murattaguss/cdtp-hasta-destek-robotu/docs/proje-yonetim-plani/100_2627G_CDTP_Yonetim_Plani_Form.docx

YTÜ YTÜ Yıldız Teknik Üniversitesi logosu

ELEKTRİK-ELEKTRONİK FAKÜLTESİ

ÇOK DİSİPLİNLİ TASARIM PROJESİ YÖNETİM PLANI

Not: Formun Arial 10 yazı tipinde doldurulması ve toplam 10 sayfayı geçmemesi gerekmektedir.

Proje Başlığı: İki Tekerlekli Ev İçi Hasta Destek Robotu

Proje Yönetim Planı Teslim Tarihi: 13.11.2026
No | Proje Ekibi Ad, Soyad | Bölüm (ELM/EHM/BLM/KOM/BME) | İmza
1 | Murat AĞUŞ | BLM
2 | Muhammed İSMAİL | BLM
3 | Ahmad KAZIMOV | EHM
4 | Doğa KILIÇ | ELM
5 | Kaan AKBIYIK | KOM
6 | Uğur Can GENÇ | KOM
Danışman: Dr. Öğr. Üyesi Bahadır ÇATALBAŞ

ÖZET

Özetin projenin yöntemi ve yönetimini ana hatlarını kapsaması beklenir. Özet 450 kelime veya bir sayfa ile sınırlandırılmalıdır. Projede yapılan tasarımda gerçekçi kısıtlar ve koşullar gözetilmelidir. Tasarımın niteliğine göre, ekonomi, çevre sorunları, sürdürülebilirlik, üretilebilirlik, etik, sağlık, güvenlik, sosyal ve politik sorunlar gibi öğeler de irdelenmelidir.

Proje Özeti

Bu projede, evde bakım gören yaşlıların veya hareket kabiliyeti kısıtlı hastaların günlük ilaç kutularının ev içinde güvenli, sarsıntısız ve devrilmeden ulaştırılmasını sağlayan iki tekerlekli aktif denge robotu, giyilebilir eldiven kumandası, otonom kızılötesi (IR) şarj istasyonu ve kamera tabanlı mobil görsel değerlendirme yazılımı tasarlanmakta ve gerçekleştirilmektedir. Sistem; Bilgisayar, Kontrol ve Otomasyon, Elektrik ile Elektronik ve Haberleşme mühendisliği disiplinlerinin ortak çalışmasıyla beş ana modülden oluşacak şekilde kurgulanmıştır.

Robot gövdesi üzerinde çift çekirdekli ESP32 (30-Pin) ana kontrolcü, MPU6050 6 eksenli ataletsel ölçüm birimi (IMU), iki adet JGB37-520 (12V, 333 RPM, 1:30 metal redüksiyonlu) kuadratür enkoderli DC motor ve iki adet BTS7960B (40A) motor sürücü kullanılmaktadır. Mekanik yapıda yalnızca gövde plakalarından oluşan iki katmanlı bir şasi kullanılacak; ekstra tekerlek ve kaplin alternatifleri 8. haftada temin edilip fiziksel kurulumla denenecektir. Gövde eğim açısı tamamlayıcı filtre (%98 jiroskop + %2 ivmeölçer) ile 200 Hz (5 ms) frekansında kestirilmekte ve eğim açısı, eğim hızı, tekerlek konumu ve tekerlek hızından oluşan durum vektörünü kullanan ayrık zamanlı LQR (Doğrusal Karesel Düzenleyici) denetleyici ile pasif destek olmadan iki eş eksenli tekerlek üzerinde aktif denge sağlanmaktadır. Kullanıcı, üzerinde NodeMCU ESP8266 ve MPU6050 bulunan bataryalı giyilebilir eldiven ile elini eğerek beş temel komutu (İleri, Geri, Sol, Sağ, Dur) ESP-NOW protokolü üzerinden düşük gecikmeyle (hedef < 50 ms) robota kablosuz iletmektedir. Görev sonunda robot, şarj istasyonunun 30 cm yarıçaplı ve 90° açılı yaklaşma bölgesine girdiğinde istasyondaki 38 kHz LTE-4208 IR verici fenerini gövde üzerindeki üç adet TSOP4038 IR alıcı ile algılayarak otonom hizalanmakta, VL53L0X mesafe sensörüyle yaklaşma hızını ayarlamakta ve robotu dik tutan dayanma yuvasındaki yaylı temas pedlerine kenetlenerek ≤ 5 s içinde insan müdahalesi olmadan şarjı ve donanımsal LED göstergeyi başlatmaktadır.

Bilgisayar Mühendisliği ekibi tarafından Flutter ile geliştirilen çapraz platform (Android ve iOS) mobil uygulama; robotun oluşturduğu yerel Wi-Fi ağı (UDP Port 4210) üzerinden 2 Hz sıklıkla gerçek zamanlı eğim açısı, batarya yüzdesi, şarj ve kenetlenme durumu, enkoder mesafesi, dönüş açısı, eldiven komutu ve ilaç kutusu varlık anahtarı (DC171) verilerini almakta, telefon kamerası ile görev sürecini canlı izleyip kare farkı yöntemiyle robotun hareketini ve yönünü tespit ederek seçilen test senaryosunun (Statik Denge, Eldivenle Yönlendirme, Otomatik Şarj, Bütünleşik Görev) kabul kriterlerini otomatik denetlemekte ve FNV-1a tabanlı 256 bit bütünlük mühürlü, sonradan değiştirilemez (salt-okunur) test raporu üretmektedir. Tasarımda 3S Li-Ion paket için BMS, 6A sigorta, ters akım diyotu ve fiziksel acil durdurma anahtarı kullanılarak güvenlik ve bütçe kısıtları gözetilmiştir.

Anahtar Kelimeler: İki Tekerlekli Aktif Denge Robotu, LQR Durum Geri Beslemeli Kontrol, Giyilebilir IMU Eldiven, ESP-NOW, Otonom Kızılötesi Şarj İstasyonu, Mobil Görsel Görev Değerlendirme, UDP Telemetri, Flutter.

1. GİRİŞ

1.1. Projenin Amacı ve Kapsamı

Projede çözülmek istenen problem, hedef kullanıcı veya uygulama ortamı ve projenin amacı açık biçimde yazılır. Problemin neden önemli olduğu kısaca açıklanır. Kapsam içinde kalan işler ile kapsam dışında bırakılan konular ayrı ayrı belirtilir.

Çözülmek İstenen Problem, Hedef Kullanıcı ve Uygulama Ortamı: Evde bakım gören yaşlıların, kronik hastaların veya hareket kısıtlılığı bulunan bireylerin günlük ilaçlarını zamanında ve güvenli biçimde alabilmesi bakım kalitesi açısından kritik önem taşımaktadır. Önceden hazırlanmış ilaç kutularının dar ev içi koridorlarda devrilmeden taşınması ve taşıyıcı robotun görev sonunda insan müdahalesi olmadan şarj olabilmesi gerekmektedir. İki tekerlekli ters sarkaç yapısı dar alanlarda yüksek manevra kabiliyeti sunarken gömülü yazılım, mobil uygulama, kontrol ve güç elektroniği disiplinlerini ortak bir problemde buluşturur.

Projenin Amacı: Dengesini yalnızca iki eş eksenli tekerlek üzerinde aktif kapalı çevrim kontrolle sağlayan bir robotun, gövdeye sabitlenmemiş standart bir ilaç kutusunu giyilebilir IMU eldiven komutlarıyla hedef noktaya düşürmeden taşıması, görev sonunda 38 kHz kızılötesi (IR) güdümle şarj istasyonuna otonom olarak kenetlenip şarjı başlatması ve tüm görev adımlarının akıllı telefon kamerası ile gerçek zamanlı UDP telemetri verileri üzerinden izlenerek mobil uygulama tarafından otomatik ve değiştirilemez (salt-okunur) biçimde raporlanmasıdır.

Proje Kapsamı İçinde Kalan İşler:

1. Aktif Denge ve Hareket Sistemi (Modül A): Yalnızca mekanik gövde plakalarından oluşan iki katmanlı şasi üzerine motor, ekstra tekerlek/kaplin alternatifleri, MPU6050 IMU ve enkoder montajının 8.–9. haftalarda gerçekleştirilmesi; tamamlayıcı filtre ile 200 Hz eğim kestirimi, LQR durum geri beslemeli denge/hareket algoritması ve jiroskop tabanlı dönüş hızı döngüsünün çalıştırılması.

2. Giyilebilir Eldiven Kumanda (Modül B): NodeMCU ESP8266 ve MPU6050 tabanlı bataryalı eldiven üzerinde açılış sıfırlama kalibrasyonu, el eğim açılarından 5 temel komutun (İleri, Geri, Sağ, Sol, Dur) üretilmesi ve ESP-NOW protokolü ile 20 Hz hızında robota kablosuz aktarımı.

3. Otomatik Şarj İstasyonu ve Güç Güvenliği (Modül C): 3S 18650 Li-Ion batarya paketi, 3S 10A BMS, 6A sigorta, ana güç anahtarı, 38 kHz LTE-4208 IR verici fenerine ve robotu dik tutan dayanma yuvasına sahip şarj istasyonu, 3x TSOP4038 IR alıcı [7] ve VL53L0X mesafe sensörü ile 30 cm / 90° bölgeden otonom kenetlenme, ≤ 5 s içinde otomatik şarj başlatma ve yazılımdan bağımsız BC557 donanımsal şarj durum LED'inin gerçekleştirilmesi.

4. Mobil Görsel İzleme, Telemetri ve Salt-Okunur Değerlendirme Yazılımı (Modül D): Flutter ile geliştirilen çapraz platform (Android/iOS) mobil uygulama üzerinden sabit telefon kamerasıyla görevin izlenmesi ve kare farkı yöntemiyle robot hareket/yön tespiti, UDP Port 4210 üzerinden ≥ 1 Hz (2 Hz) canlı telemetri (eğim açısı, batarya yüzdesi, şarj ve kenetlenme durumu, kutu teması, enkoder mesafesi, dönüş açısı, aktif eldiven komutu) alımı, ≤ 2 s bağlantı kopma denetimi, 4 test modu için otomatik değerlendirme durum makinesi işletimi ve FNV-1a tabanlı 256 bit bütünlük mühürlü salt-okunur test raporu üretimi.

5. İlaç Kutusu Taşıma Yuvası ve Bütünleşik Görev (Modül E): Gövdeye sabitlenmemiş standart ilaç kutusunun DC171 temas anahtarlı serbest yuva içinde ardışık 4 bağımsız bütünleşik görev turunda düşürülmeden taşınması.

Kapsam Dışında Bırakılan Konular: Robotun hastaya hangi ilacın verileceğine tıbbi olarak karar vermesi, ilaç dozajı ayarlaması, hastaya fiziksel müdahalede bulunması, merdiven/eşik tırmanışı ve tam 3B SLAM ev haritalaması proje kapsamı dışındadır.

1.2. Mevcut Çalışmalar ve Benzer Ürünler

Projeyle ilgili benzer proje, ürün veya çalışmalar anlatılır. Her çalışma için neyi yaptığı, sınırlılığı ve proje tasarım seçimlerini nasıl etkilediği belirtilir. Kullanılan kaynaklar “Kaynaklar” bölümünde numaralı olarak verilir.

1. Segway RMP ve Ninebot İki Tekerlekli Denge Platformları [1]: Çift tekerlekli ters sarkaç dinamiğiyle çalışan ticari taşıma platformlarıdır. Jiroskop/ivmeölçer sensör füzyonu ve yüksek torklu motorlarla çok kararlı aktif denge sağlarlar. Sınırlılığı: Boyutları, ağırlıkları ve yüksek maliyetleri ev içi masa/koridor ölçeğinde ilaç taşıma görevine uygun değildir ve otonom kenetlenmeli şarj istasyonu içermezler. Tasarımımıza Etkisi: Bu sistemlerin dayandığı durum geri beslemeli denge prensibi ölçeklendirilerek ESP32 üzerinde 200 Hz LQR kontrol döngüsüne uyarlanmıştır.

2. Arduino Tabanlı Eğitim Tipi Denge Robotu Kitleri (Elegoo Tumbller vb.) [2]: MPU6050 IMU ve iki tekerlekli çok katmanlı şasi üzerinde elle ayarlanan PID döngüleriyle denge sağlayan eğitim platformlarıdır. Sınırlılığı: Hafif gövde ve küçük motorlar için tasarlandıklarından üst katmana ek yük (ilaç kutusu ve 3S pil) eklendiğinde kazançların yeniden ayarlanması gerekmekte ve salınım artmakta; ayrıca giyilebilir eldiven kumandası, otonom şarj istasyonu ve mobil görev değerlendirme yazılımı bulunmamaktadır. Tasarımımıza Etkisi: Hazır kitler ana platform olarak kullanılamayacağından (Şartname 4.1) yalnızca mekanik gövde plakalarından oluşan iki katmanlı bir şasi temin edilmiştir. Ek yükü taşıyabilmek için 1:30 metal redüksiyonlu 12V 333 RPM JGB37-520 enkoderli motorlar ve BTS7960B sürücüler [6] temin edilmiş; ekstra tekerlek/kaplin alternatifleri 8. haftada temin edilerek şasi üzerinde en kararlı kombinasyonun deneysel olarak seçilmesi planlanmıştır. Kitlerde her döngünün kazancı deneme-yanılmayla ayarlanır; dört durumu tek bir model tabanlı kazanç matrisiyle birlikte ele aldığı için denge kontrolcüsü olarak LQR seçilmiştir.

3. Ev İçi Otonom Süpürge Robotları (iRobot Roomba Kızılötesi Kenetlenme Sistemi) [3]: Görev sonunda şarj istasyonuna dönüş için istasyon üzerindeki modüleli kızılötesi (IR) verici fenerleri ve robot üzerindeki yönlü IR alıcıları kullanarak otonom hizalanma ve yaylı kontaklarla şarj başlatma gerçekleştirirler. Sınırlılığı: Üç veya dört tekerlekli pasif dengeli gövdeye sahiptirler. Tasarımımıza Etkisi: Ortam ışığından etkilenmeyen 38 kHz taşıyıcı frekanslı IR güdüm prensibi (4x LTE-4208 verici + Sol/Orta/Sağ 3x TSOP4038 alıcı dizisi) ve yaylı temas pedleri, Modül C otomatik şarj istasyonu tasarımımıza doğrudan uyarlanmıştır.

4. IMU Tabanlı Giyilebilir Jest Kumandaları ve ESP-NOW Haberleşmesi: El sırtına yerleştirilen 6 eksenli IMU (ör. MPU6050 [5]) verilerinin mikrodenetleyici ile okunarak kablosuz komutlara dönüştürüldüğü çalışmalardır. Sınırlılığı: Klasik Bluetooth (HC-05) veya standart TCP bağlantılarında el-robot arasında gecikme ve kopmalar yaşanmaktadır. Tasarımımıza Etkisi: Eldiven (NodeMCU ESP8266) ile robot (ESP32) arasında doğrudan IEEE 802.11 MAC katmanında bağlantı kurulumu gerektirmeden çalışan ESP-NOW protokolü [4] tercih edilmiş ve komut gecikmesinin 50 ms'nin altında kalması hedeflenmiştir.

1.3. Başarı Ölçütleri

Projenin amacı ve hedefleri açık, ölçülebilir, gerçekçi ve proje süresince ulaşılabilir nitelikte olacak şekilde yazılır. Her hedef için bir başarı ölçütü, kabul değeri ve finalde nasıl doğrulanacağını gösteren test yöntemi belirtilir. Bu tablo, final raporunda hedeflerle sonuçların karşılaştırılmasının temelini oluşturur.

Hedef No | Başarı Ölçütü | Hedef Değer / Kabul Koşulu | Doğrulama (Test) Yöntemi
H1 | Aktif Statik Denge ve Eğimden Toparlanma | İlaç kutusu yüklüyken iki tekerlek üzerinde 30 s (±2 s) devrilmeden (|θ| < 5°) kalmak; ~1 m ileri gidip 3 s durmak; ~1 m geri dönüp 3 s durmak; +10° ve −10° başlangıç eğimlerinin ikisinden de ≤ 10 s içinde toparlanmak. Ön koşul: motorlar enerjisizken +10° ve −10°'den ayrı ayrı bırakılınca 5 s içinde dik konuma dönmemek ve dik durumda pasif kalmamak. | Pasif kararlılık ön testi; kronometre, uygulama eğim ve enkoder kaydı ile 30 s denge, 1 m ileri/geri git-dur ve ±10° toparlanma testleri.
H2 | Eldivenle Kablosuz Yönlendirme | 5 komuta (İleri, Geri, Sol, Sağ, Dur) ≤ 2 s içinde tepki; İleri/Geri komutunda ~0,5 m, dönüş komutunda ~90° hareket; hareketler boyunca dengenin korunması; uygulamanın Eldivenle Yönlendirme görevinde doğru yönde 0,8–1,2 m (Şartname 5.2). | Komutların eldivenle verilmesi; enkoder ve uygulama telemetrisiyle mesafe ve tepki süresinin ölçülmesi.
H3 | Otonom Şarj İstasyonuna Yaklaşma ve Şarj | 30 cm yarıçaplı, 90° açılı bölgeden IR ile otonom kenetlenme; ≤ 5 s içinde şarj ve LED göstergenin başlaması; çekilince ≤ 2 s içinde sönmesi. | Bölgeden bırakılan robotun kenetlenmesi; LED ve uygulamadaki şarj bilgisinin süre ölçümü; çek-bırak testi.
H4 | Mobil İzleme, Telemetri ve Salt-Okunur Raporlama | ≥ 1 Hz telemetri (kopma ≤ 2 s); kamera ile görev izleme; otomatik GEÇTİ/KALDI kararı ve değiştirilemez zaman damgalı rapor. | Canlı telemetri, kamera görüntüsü, kopma koruması ve üretilen raporun incelenmesi.
H5 | İlaç Kutusu Taşıma ve Bütünleşik Görev | Sabitlenmemiş ilaç kutusunu düşürmeden 5 s denge → ~1 m taşıma → 5 s bekleme → şarja yerleşme adımlarını ardışık 4 turda tamamlamak. | Bütünleşik görevin 4 kez çalıştırılması; kutu anahtarı ve uygulama raporlarıyla doğrulama.

2. SİSTEM ANALİZİ VE FİZİBİLİTE

2.1. Sistem Gereksinimleri ve Kısıtlar

Sistemin yapması gereken işler ile performans, enerji, güvenlik, maliyet ve boyut gibi kısıtlar yazılır. Her gereksinim test edilebilir biçimde ifade edilir ve karşıladığı hedefe bağlanır.

No | Gereksinim / Kısıt | Bağlı Hedef
G1 | Mekanik ve Aktif Denge Kısıtı: Robot yalnızca iki eş eksenli tekerlek üzerinde dengelenmeli, üçüncü destek tekeri veya sabit ayak bulunmamalıdır. Motorlar enerjisizken +10° ve −10° eğimden ayrı ayrı bırakıldığında 5 s içinde dik konuma geri dönmemeli veya dik durumda pasif biçimde kalmamalıdır. | H1, H5
G2 | Denge Kontrol Döngüsü ve Devrilme Güvenliği: Gövde eğim açısı ölçümü (MPU6050) ve LQR durum geri beslemeli motor kontrol döngüsü en az 200 Hz (5 ms periyot) hızında çalışmalı; gövde eğimi ±35° sınırını aştığında motor PWM çıkışları güvenlik amacıyla otomatik kesilmelidir. | H1, H5
G3 | Giyilebilir Komut Gecikmesi ve Kalibrasyon: Eldiven kumanda bataryalı (şebekeden yalıtımlı) olmalı, açılışta elin doğal duruş açısını sıfırlayabilmeli ve 5 temel komutu ESP-NOW üzerinden ≤ 2 s fiziksel tepki süresiyle robota iletmelidir. | H2
G4 | Otonom Şarj ve Donanımsal Gösterge Kısıtı: 30 cm / 90° yaklaşma bölgesinden itibaren insan müdahalesi olmadan 38 kHz IR güdümle yönünü, istasyona kalan mesafeye göre hızını ayarlayarak kenetlenmeli; robot istasyondaki dayanma yuvasına yaslanarak dik (|θ| ≤ 10°) kalmalı ve motorlar ancak robot sabitlendikten sonra durdurulmalı (Şartname 4.3); şarj ≤ 5 s içinde başlamalı, çekildiğinde ≤ 2 s içinde kesilmeli ve şarj LED'i yazılımdan bağımsız olarak doğrudan şarj devresi tarafından sürülmelidir. | H3
G5 | Mobil Telemetri Sürekliliği ve Kamera İzleme: Mobil uygulama görev boyunca robotla UDP 4210 üzerinden en az 1 Hz (hedef 2 Hz) sıklıkla haberleşmeli, 2 s'den uzun bağlantı kopmasını hata olarak algılamalı ve sabit kamera görüntüsüyle telemetriyi eşzamanlı göstermelidir. | H4, H5
G6 | Salt-Okunur Raporlama ve Veri Bütünlüğü: Her görev sonunda üretilen test raporu tarih/saat, görev türü, süre, eğim, şarj, kutu durumu ve GEÇTİ/KALDI kararını içermeli; FNV-1a özetiyle mühürlenerek uygulama içinden silinemez ve değiştirilemez (salt-okunur) olmalıdır. | H4, H5
G7 | Elektriksel Güvenlik, Ergonomi ve Bütçe Kısıtı: Sistem ana beslemesi 24 V DC'yi aşmamalı (3S Li-Ion 11,1V–12,6V), batarya paketinde 3S 10A BMS, ana hatta 6A sigorta, şarj girişinde 1N5822 ters akım diyotu ve fiziksel ana güç kesme anahtarı bulunmalı; toplam maliyet bütçe sınırları içinde kalmalıdır. | H1, H3, H5

2.2. Çözümlerin Değerlendirilmesi

Önemli tasarım kararları için uygulanabilir en az iki alternatif karşılaştırılır. Karşılaştırma ölçütleri (maliyet, performans, temin edilebilirlik, süre vb.) belirtilir; önerilen seçim gerekçesiyle birlikte yazılır. Henüz kesinleşmeyen kararlar açıkça belirtilmelidir.

Problem | Çözümler | Karşılaştırma Ölçütleri | Önerilen Seçim ve Gerekçesi
1. Şasi, Motor ve Tekerlek | A: İki katmanlı gövde ile standart plastik dişli motor/tekerlek. B: İki katmanlı gövde + JGB37-520 motor, L-braket, altıgen kaplin, ekstra tekerlek. | Dişli boşluğu, tork, ağırlık merkezi, zemin tutuşu. | Seçim henüz kesinleşmedi: B'nin motor ve sürücüleri temin edildi; ekstra tekerlek/kaplin/braket parçaları 8. haftada temin edilecek, montajda tekerlek/motor yerleşimleri denenerek en az salınımlı olan seçilecek. Gövde setinden yalnızca mekanik plakalar kullanılır; set elektronik, motor veya yazılım içermez (Şartname 4.1).
2. Haberleşme (Eldiven–Robot, Robot–Telefon) | A: Bluetooth SPP (HC-05). B: Eldiven→Robot ESP-NOW, Robot↔Telefon Wi-Fi UDP 4210. | Gecikme, eşzamanlı bağlantı, ek maliyet. | Seçim: B. Dahili Wi-Fi ek modül gerektirmez; ESP-NOW ile < 50 ms gecikme hedeflenir, telefon aynı anda UDP ile 2 Hz veri alır.
3. Mobil Uygulama | A: Hazır Bluetooth terminal uygulaması. B: Flutter ile özel çapraz platform uygulama [8]. | Kamera ve telemetri tek ekranda, otomatik karar, salt-okunur rapor. | Seçim: B. Şartnamedeki kamera izleme, telemetri ve değiştirilemez rapor hazır uygulamalarla sağlanamaz.
4. Şarj İstasyonu Güdümü | A: Kamera/ultrasonik güdüm + endüktif şarj. B: 38 kHz IR fener (LTE-4208) + 3x TSOP4038 [7] + yaylı temas pedleri. | Ortam ışığı etkisi, algılama başarısı, ≤ 5 s şarj, maliyet. | Seçim: B. TSOP4038 sürekli 38 kHz sinyal için tasarlanmış ışık bariyeri tipi bir alıcıdır ve yalnızca 38 kHz'e duyarlı olduğundan ortam ışığından etkilenmez; temas pedleri hizalama toleransı sağlar.
5. Denge Kontrolcüsü | A: Ayrık zamanlı PID (yalnızca eğim hatası). B: LQR durum geri beslemesi, u = −K·x; x = [eğim, eğim hızı, tekerlek konumu, tekerlek hızı] [9]. | Yük altında salınım, konum kayması, ayar kolaylığı, hesaplama yükü. | Seçim: B. LQR dört durumu tek kazanç matrisiyle birlikte denetler, ilaç kutusu yükünde salınımı ve yerinde kaymayı azaltır. Enkoder durumlarını da kullandığından yalnız eğime bakan denetleyiciye göre konum kaymasını önlemesi beklenmektedir; bu karşılaştırma montajdan sonra gerçek robotta yapılacaktır. K, doğrusallaştırılmış robot modelinden Q/R ağırlıklarıyla çevrimdışı hesaplanır; ESP32 her 5 ms’de yalnızca 4 çarpım yapar.

2.3. Teknik ve Ekonomik Fizibilite

2.3.1. Teknik fizibilite

Her alt sistem için gerekli kaynak ve beceriler ile işin proje süresinde neden yapılabilir olduğu açıklanır. Zorluğu yüksek veya ekipte karşılığı bulunmayan konular belirtilir ve bunlar için çözüm yolu yazılır.

Alt Sistem | Gerekli Kaynak / Beceri | Yapılabilirlik Gerekçesi
1. Mobil Uygulama ve Raporlama (Modül D) – Sorumlu: Murat AĞUŞ, Muhammed İSMAİL | Flutter/Dart, UDP soket programlama, kamera akışında kare farkı ile hareket tespiti, görev durum makinesi, FNV-1a ile salt-okunur rapor. | Uygulama geliştirilmiş, Android ve iOS için derlenmiştir; yalnızca robotun UDP paketlerini işlediğinden robot hazır olunca kullanılır. Gerçek robotla doğrulama 9.–12. haftalarda yapılacaktır.
2. Denge ve Hareket Kontrolü (Modül A) – Sorumlu: Kaan AKBIYIK, Uğur Can GENÇ | Tamamlayıcı filtre, ters sarkaç modeli, 200 Hz LQR (K matrisi MATLAB/Python ile hesaplanır), BTS7960B PWM, enkoder odometri. | Fiziksel robot henüz kurulmadığından denetleyici tasarımı bu aşamada model üzerinde yürütülmektedir. DC motor ve dişli kutusu dinamiğini içeren voltaj girişli doğrusallaştırılmış robot modeli kurulmuş (benzer yaklaşım: [10]) ve LQR kazancı bu modelden hesaplanmıştır; MATLAB/Simulink'teki simülasyon çalışmaları sürmektedir. Kontrol yazılımının ilk sürümü yazılmış, şasi ve motorlar mevcuttur. Montajda şasinin kütle ve boyutları ölçülerek model güncellenecek, K yeniden hesaplanıp ESP32'ye aktarılacak ve Q/R ağırlıkları 8.–9. haftalarda gerçek robot üzerinde ince ayarlanacaktır.
3. Eldiven ve ESP-NOW (Modül B) – Sorumlu: Ahmad KAZIMOV, Muhammed İSMAİL | I2C MPU6050 okuma, açılış kalibrasyonu, 5 yönlü açı sınıflandırma, ESP-NOW. | Eldiven yazılımının ilk sürümü yazılmış, pil ve şarj modülü temin edilmiştir. Açı eşikleri (±20°/±22°) eldivenle denenerek ayarlanacaktır.
4. Güç ve Şarj İstasyonu (Modül C) – Sorumlu: Doğa KILIÇ, Ahmad KAZIMOV | 3S batarya yönetimi, DC-DC regülasyon, sigorta/diyot koruması, 38 kHz IR verici/alıcı, donanımsal şarj göstergesi. | Elektronik bileşenler ve istasyonu besleyecek 9V 2A adaptör temin edilmiştir; şarj göstergesi yazılımdan bağımsız BC557 devresiyle sürülecektir. İstasyon devresi 5.–8. haftalarda kurulacaktır.
5. İlaç Kutusu Yuvası ve Entegrasyon (Modül E) – Sorumlu: Tüm Ekip | Ağırlık merkezi dengeleme, serbest yuva ve DC171 anahtar montajı, modüllerin entegrasyonu. | DC171 anahtarı temin edilmiştir; montaj 8. haftada başlayacak, 11.–14. haftalardaki provalarla süre içinde tamamlanabilir.

2.3.2. Ekonomik fizibilite

Projede kullanılacak malzeme, yazılım ve hizmet kalemleri adet, birim fiyat, durum (mevcut/temin edilecek) ve tedarik süresiyle listelenir. Toplam bütçe belirtilir. Tedarik süreleri iş planıyla uyumlu olmalıdır.

Kalem | Adet | Birim (₺) | Tutar (₺) | Durum | Tedarik Süresi
ESP32 ESP-32S Wi-Fi + Bluetooth Geliştirme Kartı (30 Pin) | 1 | 423,67 | 423,67 | Mevcut | Tamamlandı
NodeMCU V3 ESP8266 (ESP-12E) Geliştirme Kartı | 1 | 185,00 | 185,00 | Mevcut | Tamamlandı
MPU6050 6 Eksen İvme ve Gyro Sensörü (GY-521) | 2 | 193,95 | 387,90 | Mevcut | Tamamlandı
JGB37-520 12V 333 RPM (1:30) Enkoderli Metal Redüktörlü DC Motor | 2 | 639,29 | 1.278,58 | Mevcut | Tamamlandı
BTS7960B 40A Çift Yönlü H-Köprüsü DC Motor Sürücü Kartı | 2 | 263,66 | 527,32 | Mevcut | Tamamlandı
TSOP4038 38 kHz IR Alıcı Sensör (3 Adet) + LTE-4208 IR LED (4 Adet) | 1 Set | 179,44 | 179,44 | Mevcut | Tamamlandı
DC171 Micro Switch (2 Adet) + GY-530 (VL53L0X) ToF Mesafe Sensörü | 1 Set | 172,74 | 172,74 | Mevcut | Tamamlandı
3S Robot Güç Paketi (3x Orion 18650 2000mAh 15C Pil, 3S 10A BMS, Pil Yatağı) | 1 Set | 645,00 | 645,00 | Mevcut | Tamamlandı
Eldiven Güç Paketi (Power-Xtra 3.7V 1000mAh Li-Po Pil + TP4056 Type-C Şarj) | 1 Set | 237,59 | 237,59 | Mevcut | Tamamlandı
Şarj İstasyonu ve Koruma Elektroniği (2x IP2326, 2x Mini360, 6A Sigorta, 1N5822, BC557, Kablo/Klemens) | 1 Set | 582,16 | 582,16 | Mevcut | Tamamlandı
İki Katmanlı Robot Gövdesi (Yalnız Mekanik Plakalar) | 1 Set | 650,00 | 650,00 | Mevcut | Tamamlandı
Concord 9V 2A AC/DC Adaptör (Şarj İstasyonu Beslemesi) | 1 | 249,00 | 249,00 | Mevcut | Tamamlandı
Ekstra Tekerlek Çifti, 6mm Altıgen Kaplin, 37mm L-Braket ve Montaj Aparatları | 1 Set | 550,00 | 550,00 | Temin edilecek | 8. Hafta
TOPLAM | | | 6.068,40 ₺

2.3.3. Zaman ve iş gücü fizibilitesi

Projenin kalan süre içinde tamamlanabilirliği, kritik yol ve kilometre taşları ile ekibin iş gücü (kişi/saat) bakımından değerlendirilir. Projede yer alacak başlıca iş paketleri, her birinin somut çıktısı, kimler tarafından ve hangi sürede gerçekleştirileceği aşağıdaki “İş-Zaman Çizelgesi” doldurularak verilir.

İş Gücü Kapasitesi (Kişi-Saat Analizi): Projede toplam 6 ekip üyesi (2 BLM, 2 KOM, 1 ELM, 1 EHM) görev almaktadır. Her ekip üyesinin haftalık ortalama 6 saat proje çalışması yürütmesiyle 14 haftalık dönemde toplam 6 x 6 x 14 = 504 kişi-saat iş gücü kapasitesi bulunmaktadır. Elektronik, motor, sensör, batarya ve gövde tedarikinin %90'ı ile Bilgisayar Mühendisliği ekibinin geliştirdiği mobil uygulama ve ESP32/ESP8266 gömülü yazılım mimarileri ilk 4 hafta itibarıyla tamamlanmış durumdadır.

Kritik Yol ve Kilometre Taşları: Proje takviminde 1.–4. haftalarda sistem analizi, malzeme/gövde alımı ve mobil/gömülü yazılımların kodlanması tamamlanmıştır. 5.–8. haftalarda eldiven kumanda (Modül B) ve şarj istasyonu/güç koruma (Modül C) devrelerinin masaüstü doğrulama testleri yapılacaktır. Fiziksel robotun mekanik ve elektriksel kurulumuna 8. haftada başlanacak; şasi üzerinde denenecek ekstra tekerlek/kaplin/braket parçaları 8. haftada temin edilecektir:

• KM1 (4. Hafta): Sistem mimarisi, malzeme ve gövde tedariki, mobil değerlendirme uygulaması ve ESP32/ESP8266 gömülü yazılımlarının tamamlanması.

• KM2 (8. Hafta): Eldiven ve IR şarj istasyonu devrelerinin masaüstü testleri.

• KM3 (8.–9. Hafta – Kritik Yol): Fiziksel robotun 8. haftada iki katmanlı gövde üzerinde kurulması, 8. haftada temin edilen ekstra tekerlek/kaplin parçalarıyla tekerlek/motor bağlantı kombinasyonlarının denenerek en kararlı yapının seçilmesi ve 200 Hz LQR (Q/R ağırlık) ayarlarıyla 30 s aktif statik dengenin + ±10° toparlanmanın sağlanması.

• KM4 (10.–12. Hafta): Eldivenle hareket kontrolü, IR güdümlü otonom şarja kenetlenme, ilaç kutusu yuvası ve mobil uygulamanın robotla uçtan uca entegrasyonu.

• KM5 (13.–14. Hafta ve Final Haftası): Ortak test protokolüne (5x20 puan) göre 4 ardışık bağımsız tur bütünleşik görev provalarının tamamlanması, salt-okunur mobil raporların doğrulanması ve final sunumu.

İŞ-ZAMAN ÇİZELGESİ

İP No | İş Paketinin Adı | İş Paketinin Tanımı | Kim(ler) Tarafından Gerçekleştirileceği | HAFTALAR
| | | | 1 | 2 | 3 | 4 | 5 | 6 | 7 | 8 | 9 | 10 | 11 | 12 | 13 | 14 | Final Haftası
1 | Sistem Analizi ve Tedarik | İsterler, arayüzler, malzeme ve gövde temini. | Tüm Ekip | X | X | X | X
2 | Mobil Uygulama (Modül D) | Kamera, UDP telemetri, görev değerlendirme, salt-okunur rapor. | Murat AĞUŞ, Muhammed İSMAİL | | X | X | X | X | X
3 | Gömülü Yazılımlar | Robot (ESP32) ve eldiven (ESP8266) yazılımları. | Murat AĞUŞ, Muhammed İSMAİL | | | X | X | X | X
4 | Güç, Şarj İstasyonu ve Eldiven Devreleri (Modül B, C) | Güç/koruma katı, IR şarj istasyonu, eldiven devresi. | Doğa KILIÇ, Ahmad KAZIMOV | | | | | X | X | X | X
5 | Robot Montajı ve Aktif Denge (Modül A) | Gövde, motor, tekerlek montajı ve LQR ile 30 s denge. | Kaan AKBIYIK, Uğur Can GENÇ | | | | | | | | X | X
6 | Eldivenle Hareket ve Otonom Şarj | 5 komutlu sürüş ve IR ile şarja kenetlenme. | Kaan AKBIYIK, Uğur Can GENÇ, Doğa KILIÇ, Ahmad KAZIMOV | | | | | | | | | X | X
7 | Kutu Yuvası ve Uçtan Uca Entegrasyon (Modül E) | Kutu yuvası montajı; robot ve uygulama entegrasyon testleri. | Tüm Ekip | | | | | | | | | | | X | X
8 | Ortak Provalar ve Final | 4 turluk bütünleşik görev provaları, düzeltmeler, final sunumu. | Tüm Ekip | | | | | | | | | | | | X | X | X | X

3. SİSTEM TASARIMI

3.1. Sistem Mimarisi

3.1.1. Mimari Diyagram

Sistemin genel çalışma mantığını gösteren blok diyagramı eklenir. Donanım, yazılım ve haberleşme alt sistemlerinin birbiriyle etkileşimi diyagramda görülebilmelidir.

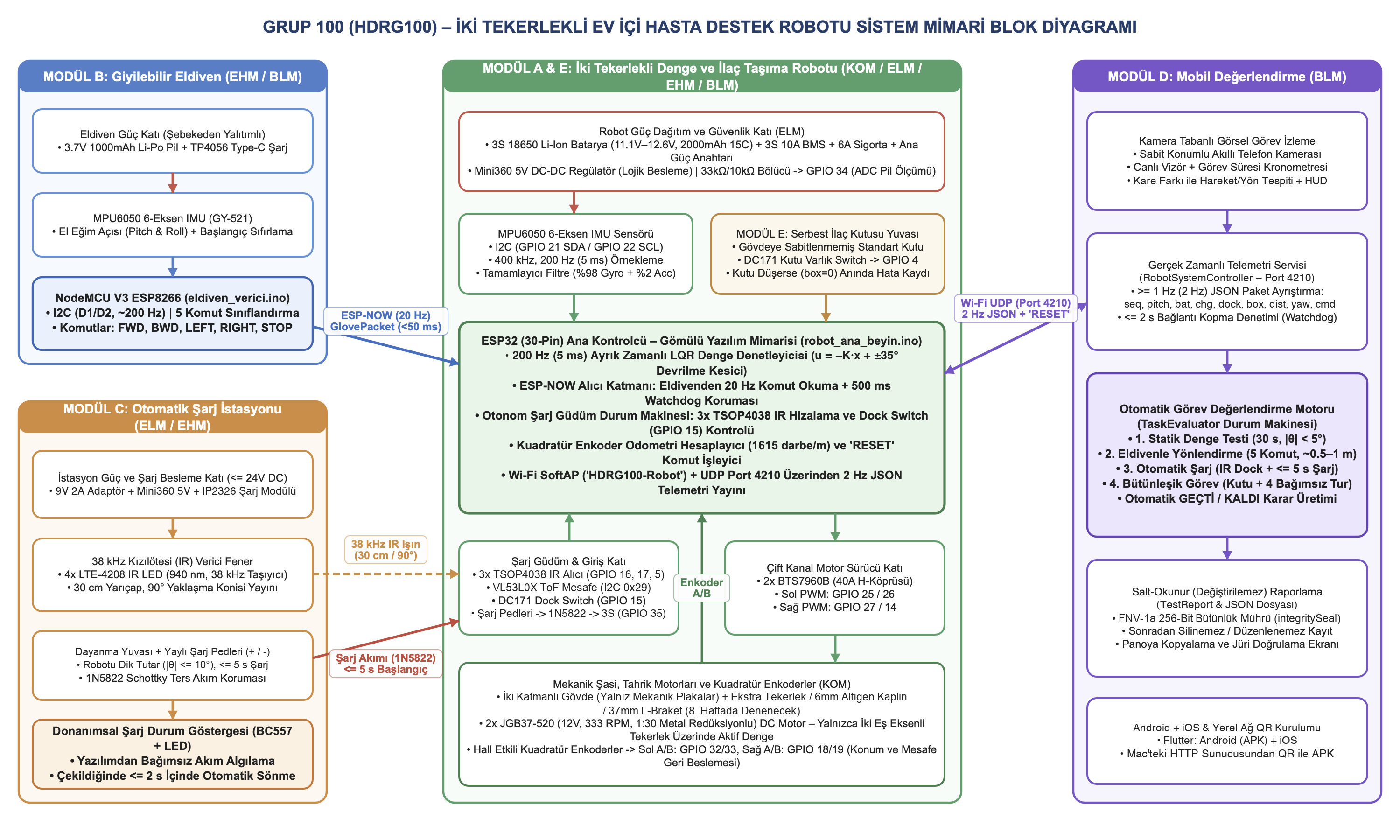
[picture p5: figure]
Sistem_Mimari_Blok_Diyagrami

Şekil 3.1: İki Tekerlekli Ev İçi Hasta Destek Robotu Donanım, Gömülü Yazılım, Kablosuz Haberleşme ve Mobil Değerlendirme Sistemi Mimari Blok Diyagramı.

3.1.2. Alt Sistemler ve Bileşenler

Ana alt sistemlerin görevleri, temel girdileri/çıktıları ve diğer alt sistemlerle bağlantıları açıklanır. Proje türüne göre donanım, yazılım, elektronik veya mekanik bileşenler kullanılabilir.

Alt Sistem / Modül | Görev | Girdi / Çıktı ve Bağlantılar
Modül A: Aktif Denge ve Tahrik (ESP32 + MPU6050 + 2x BTS7960B [6] + 2x JGB37-520) Sorumlu: Kaan AKBIYIK, Uğur Can GENÇ | İki tekerlek üzerinde 200 Hz LQR ile denge; eldiven komutlarını uygulamak; dönüşü ayrı bir döngüyle denetlemek (jiroskop z ekseninden ölçülen dönüş hızı, ileri besleme + oransal kazanç; çıkış iki motora zıt işaretle LQR çıkışına eklenir, ~90° dönüş ve IR hizalamada kullanılır); ±35° aşımında motorları kesmek; enkoderle mesafe ölçmek. | Girdi: MPU6050 (I2C: GPIO 21/22), enkoder A/B (GPIO 32, 33, 18, 19; A kanalı yükselen kenar, 65 mm teker için ≈1615 darbe/m, teker çapına göre güncellenir), ESP-NOW komutu, UDP 'RESET'. Çıktı: BTS7960B PWM (GPIO 25/26, 27/14), UDP telemetri.
Modül B: Giyilebilir Eldiven (NodeMCU ESP8266 + MPU6050 + Li-Po) Sorumlu: Ahmad KAZIMOV, Muhammed İSMAİL | Açılışta el duruşunu sıfırlamak, el eğimini 5 komuta (FWD, BWD, LEFT, RIGHT, STOP) çevirip robota göndermek. | Girdi: MPU6050 (I2C: D1/D2), 3.7V Li-Po. Çıktı: ESP-NOW (kanal 1) ile 20 Hz komut paketi, durum LED'i.
Modül C: Güç ve Şarj İstasyonu (3S BMS + sigorta + LTE-4208 + 3x TSOP4038 [7] + VL53L0X + BC557) Sorumlu: Doğa KILIÇ, Ahmad KAZIMOV | Robotu güvenle beslemek; 38 kHz IR ile yönünü, ToF mesafesiyle yaklaşma hızını ayarlayarak istasyona yönlendirmek; robotu dayanma yuvasında dik tutmak; kenetlenmede ≤ 5 s içinde şarjı ve donanımsal LED'i başlatmak. | Girdi: 9V 2A adaptör (istasyon beslemesi); 38 kHz IR → TSOP4038 (GPIO 16, 17, 5); VL53L0X ToF (I2C 0x29, MPU6050 ile ortak hat GPIO 21/22); DC171 kenetlenme anahtarı (GPIO 15); pil ve şarj girişi gerilim bölücüleri (GPIO 34, 35). Çıktı: 1N5822 üzerinden şarj akımı, BC557 şarj LED'i.
Modül D: Mobil Uygulama (Flutter) Sorumlu: Murat AĞUŞ, Muhammed İSMAİL | Telefon kamerasıyla görevi izlemek, telemetriyi göstermek, 4 görevi otomatik değerlendirmek, salt-okunur rapor kaydetmek. | Girdi: Wi-Fi UDP 4210 JSON telemetri, kamera görüntüsü. Çıktı: Canlı ekran, GEÇTİ/KALDI kararı, 'RESET' komutu, değiştirilemez rapor.
Modül E: Serbest İlaç Kutusu Yuvası (DC171) Sorumlu: Tüm Ekip | Kutuyu sabitlemeden taşımak ve yuvada olup olmadığını denetlemek. | Girdi: DC171 (GPIO 4). Çıktı: box: 1 / 0 bayrağı (düşerse test KALDI).

3.1.3. Arayüzler ve Haberleşme

Alt sistemler arasındaki her bağlantı için kullanılan ortam veya protokol, taşınan veri ve hedeflenen performans (gecikme, hız, hata payı vb.) belirtilir. Bu bağlantılar 3.2’deki görev akışı ile uyumlu olmalıdır.

Bağlantı | Ortam / Protokol | Veri İçeriği | Hedef
IMU / ToF Sensörleri → Mikrodenetleyiciler (Robot & Eldiven) | Kablolu / I2C Veri Yolu (400 kHz Fast Mode) | 0x68 adresli MPU6050'den 14 byte ham 3-eksen ivmeölçer ve 3-eksen jiroskop register verisi (0x3B–0x48); robotta ayrıca 0x29 adresli VL53L0X'ten istasyon mesafesi (mm). | Robot üzerinde 200 Hz (5 ms), eldiven üzerinde ~200 Hz deterministik örnekleme; < 1 ms okuma süresi; ToF ~20 Hz, denge döngüsünü bekletmeden okunur.
Giyilebilir Eldiven (ESP8266) → Robot Ana Kontrolcü (ESP32) | Kablosuz / 2.4 GHz ESP-NOW (IEEE 802.11 MAC Katmanı, Kanal 1) | 20 byte yapılandırılmış paket: sıra no (seq), komut ('FWD', 'BWD', 'LEFT', 'RIGHT', 'STOP'), el eğim açıları (pitch, roll). | 20 Hz (50 ms) gönderim sıklığı, < 50 ms uçtan uca gecikme hedefi (şartname sınırı ≤ 2 s); 500 ms paket gelmezse otomatik STOP koruması.
Otomatik Şarj İstasyonu → Robot Güdüm Alıcıları ve Şarj Hattı | Optik Kablosuz (38 kHz 940 nm IR) + Fiziksel Yaylı Metal Kontak | 3x TSOP4038 üzerinde yönlü aktif-düşük (LOW) istasyon algılama sinyali; kenetlenmede DC171 switch (GPIO 15) ve 12.6V şarj akımı. | 30 cm yarıçaplı, 90° açılı yaklaşma bölgesinde ortam ışığından etkilenmeden 10 denemenin en az 9'unda algılama; kenetlenmeden sonra ≤ 5 s içinde şarj başlangıcı.
Robot (ESP32) → Mobil Uygulama | Kablosuz / Wi-Fi SoftAP – UDP Port 4210 (telefona tekil gönderim) | UTF-8 JSON Telemetri Paketi: {"seq":N, "pitch":deg, "bat":%, "chg":0/1, "dock":0/1, "box":0/1, "dist":m, "yaw":deg, "rst":n, "cmd":"..."} | 2 Hz (500 ms periyot) kesintisiz yayın (şartname minimumu ≥ 1 Hz); görev sırasında izin verilen maksimum kopma süresi ≤ 2 s.

3.2. Sistemin Çalışma Prensibi ve Görev Akışı

Önce sistemin genel çalışma prensibi anlatılır: sistemi oluşturan parçalar, her birinin görevi, parçalar arasında hangi bilgi veya enerjinin aktığı ve sistemin hedefine nasıl ulaştığı mimari diyagramdaki kutu ve oklara atıf yapılarak açıklanır; 3.1.2 ve 3.1.3’teki tabloların neyi gösterdiği belirtilir. Ardından sistemin baştan sona görev akışını gösteren akış şeması eklenir ve akış adım adım yazılarak anlatılır; her adımda hangi alt sistemin görev aldığı ve verinin hangi bağlantıdan aktığı belirtilir. Hata ve güvenlik durumlarının nasıl ele alınacağı da yazılır.

1. Sistemin Genel Çalışma Prensibi: Sistemin çalışma yapısı, Bölüm 3.1.1'deki Mimari Diyagramda (Şekil 3.1) gösterilen dört ana donanım/yazılım bloğunun (Modül B Eldiven, Modül A & E Denge Robotu, Modül C Otomatik Şarj İstasyonu ve Modül D Mobil Değerlendirme Sistemi) eşzamanlı etkileşimine dayanmaktadır. Bölüm 3.1.2'deki tablo her bir modülün görevini, mikrodenetleyici pinlerini ve sensör/eyleyici bağlantılarını tanımlarken; Bölüm 3.1.3'teki tablo bu bloklar arasındaki kablolu (I2C) ve kablosuz (ESP-NOW, 38 kHz IR, Wi-Fi UDP 4210) veri paketlerini ve zamanlama hedeflerini göstermektedir. ESP32, MPU6050 verilerini 200 Hz okuyup tamamlayıcı filtre ile eğim açısını hesaplar ve LQR durum geri beslemesiyle (u = −K·x) JGB37-520 motorları sürerek robotu iki tekerlek üzerinde dik tutar.

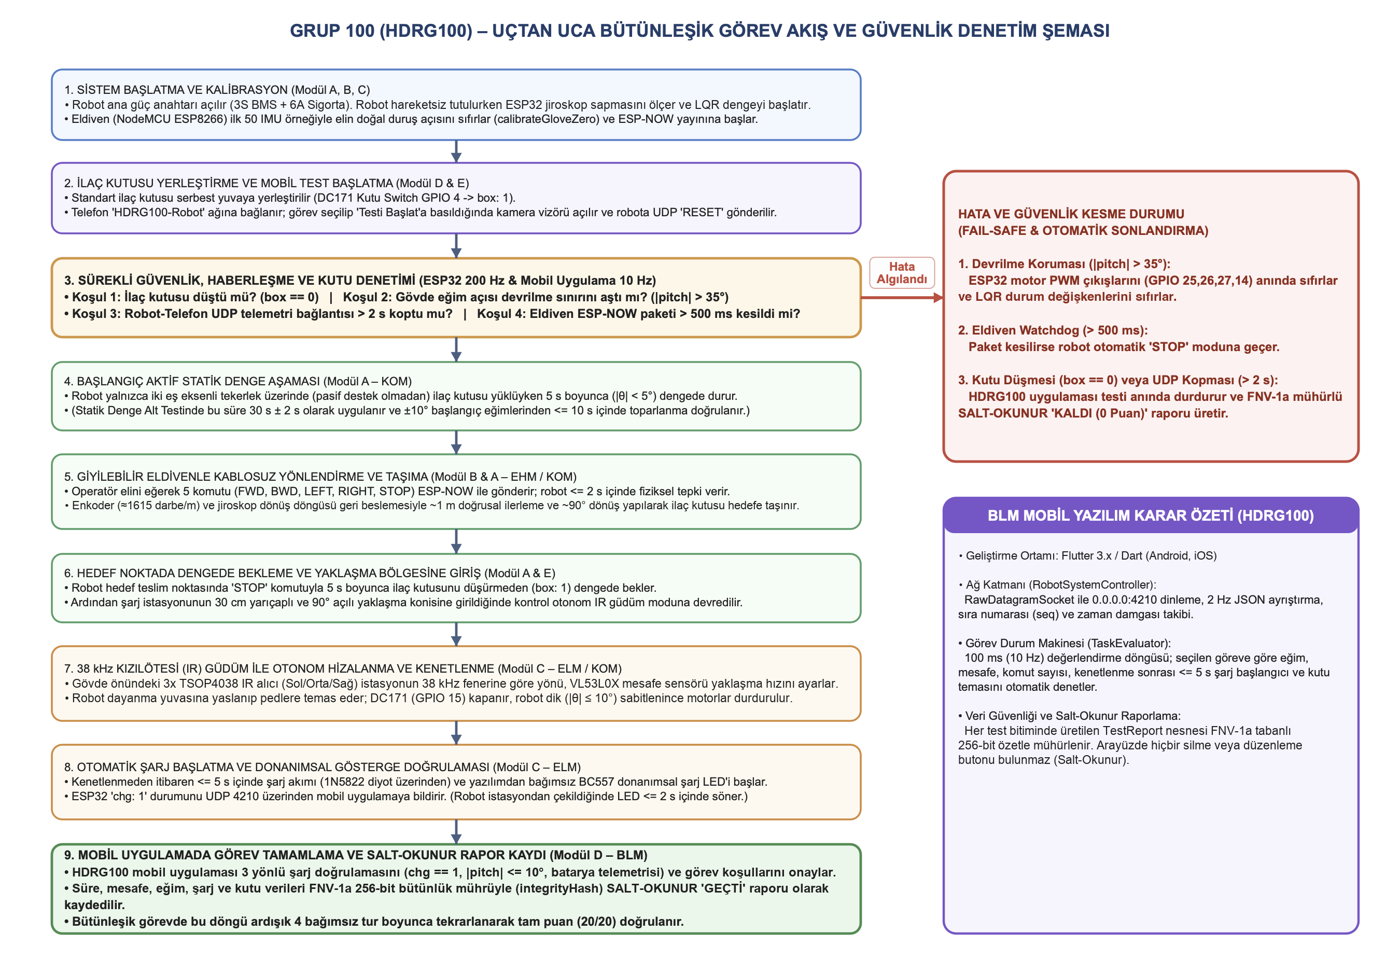
[picture p6: figure]
Gorev_Akis_Semasi

Şekil 3.2: İki Tekerlekli Ev İçi Hasta Destek Robotu Baştan Sona Görev Akış ve Hata/Güvenlik Denetim Şeması.

2. Adım Adım Görev Akışı: (1–2) Robot ve eldiven açılır; robot hareketsiz tutulurken ESP32 jiroskop sapmasını ölçer ve LQR dengeyi başlatır, eldiven elin duruşunu sıfırlar. İlaç kutusu yuvaya konur (box: 1); telefon robotun Wi-Fi ağına bağlanır, görev seçilip 'Testi Başlat' ile kamera ve kronometre başlar, robota 'RESET' gönderilir. (3–6) Robot önce dengesini korur; eldivenden ESP-NOW ile gelen FWD/BWD/LEFT/RIGHT/STOP komutlarına ≤ 2 s içinde tepki verir, enkoder geri beslemesi ve jiroskop dönüş döngüsüyle ~1 m ilerler, ~90° döner ve hedefte 5 s bekler. (7–9) Yaklaşma bölgesinde 3x TSOP4038 istasyonun 38 kHz IR fenerini algılar; robot yönünü IR alıcılarına, hızını ToF mesafesine göre ayarlayarak yaklaşır ve dayanma yuvasına yaslanarak kenetlenir (dock: 1); robot dik (|θ| ≤ 10°) sabitlenince motorlar durdurulur, ≤ 5 s içinde şarj (chg: 1) ve donanımsal LED başlar; mobil uygulama kriterleri doğrulayıp salt-okunur GEÇTİ raporunu kaydeder.

3. Hata ve Güvenlik Durumlarının Ele Alınması: (a) Devrilme Koruması: Gövde eğim açısı ±35°'yi aşarsa, ESP32 motor PWM çıkışlarını (GPIO 25, 26, 27, 14) anında sıfırlayarak tekerleklerin havada boşa dönmesini engeller. (b) Eldiven Haberleşme Koruması: Eldivenden 500 ms boyunca ESP-NOW paketi alınamazsa robot otomatik olarak 'STOP' durumuna geçer. (c) Mobil Telemetri ve Kutu Düşme Denetimi: Görev sırasında ilaç kutusu yuvadan düşerse (box == 0) veya Robot–Telefon arası UDP 4210 telemetri akışı > 2 s kesilirse, mobil uygulama testi otomatik olarak durdurur ve değiştirilemez 'KALDI (0 Puan)' raporu üretir. (d) Elektriksel Koruma: 3S 10A BMS, 6A sigorta, 1N5822 Schottky ters akım diyotu ve fiziksel ana güç kesme anahtarı ile tam koruma sağlanmıştır.

KAYNAKLAR

Projede kullanılan veri sayfası, ürün sayfası, açık kaynak depo ve benzer çalışmalar numaralı olarak ve erişim tarihiyle verilir. Metin içinde kaynak numarasıyla atıf yapılmalıdır.

[1] Segway Robotics, "Robotics Mobility Platform (RMP)," [Çevrimiçi]. Erişim: https://robotics.segway.com/rmp/. [Erişim Tarihi: 10.11.2026].

[2] ELEGOO, "Tumbller Self-Balancing Robot Car Kit," [Çevrimiçi]. Erişim: https://us.elegoo.com/products/elegoo-tumbller-self-balancing-robot-car. [Erişim Tarihi: 10.11.2026].

[3] D. A. Cohen, D. Ozick, C. Vu, J. Lynch ve P. R. Mass (iRobot Corp.), "Autonomous Robot Auto-Docking and Energy Management Systems and Methods," U.S. Patent 7,332,890 B2, 19.02.2008.

[4] Espressif Systems, "ESP-NOW," ESP-IDF Programming Guide (ESP32), [Çevrimiçi]. Erişim: https://docs.espressif.com/projects/esp-idf/en/latest/esp32/api-reference/network/esp_now.html. [Erişim Tarihi: 27.10.2026].

[5] InvenSense Inc., "MPU-6000 and MPU-6050 Product Specification," Doküman No. PS-MPU-6000A-00, Rev. 3.4, Ağustos 2013.

[6] Infineon Technologies, "BTS 7960 High Current PN Half Bridge NovalithIC," Veri Sayfası, Rev. 1.1, Aralık 2004.

[7] Vishay Semiconductors, "TSOP4038 – IR Receiver Module for Light Barrier Systems," Doküman No. 81926, Rev. 1.2, Mart 2012.

[8] Google, "Flutter Documentation," [Çevrimiçi]. Erişim: https://docs.flutter.dev. [Erişim Tarihi: 29.10.2026].

[9] K. Ogata, "Modern Control Engineering," 5th ed., Pearson, 2010, Bölüm 10: Control Systems Design in State Space, Kısım 10-8: Quadratic Optimal Regulator Systems.

[10] P. Frankovský, L. Dominik, A. Gmiterko, I. Virgala, P. Kuryło ve O. Perminova, "Modeling of Two-Wheeled Self-Balancing Robot Driven by DC Gearmotors," International Journal of Applied Mechanics and Engineering, c. 22, sy. 3, ss. 739–747, 2017, doi: 10.1515/ijame-2017-0046.

Doküman No: FR-1558; Revizyon Tarihi: 02.11.2026; Revizyon No: 01
